joshatron/LED-Cube/4x4x4_build.md

4x4x4 LED Cube Build
====================

Before attempting a full 8x8x8 cube, I started by creating a 4x4x4 one.

Supplies
--------

Materials:

 * 64 LEDs (I chose blue, diffuse is better)
 * 3 ft solid core wire (I had some 22 guage lying around)
 * 15 ft small guage wire (rough approximation, for routing on protoboard)
 * 16 resistors (For mine, I used 200 ohms)
 * 1 large protoboard (Should be at least 4 inches in the smaller dimension)
 * 1 arduino (I used a mega 2560, but an uno should work too)
 * 1 small protoboard (Optional, used to make easy connection to arduino)
 * 20 pin headers (Optional, used to make easy connection to arduino)

Tools:

 * Soldering iron (Ideally a nicer one since you will be doing a lot of soldering)
 * Solder (You will need a pretty good amount of this)
 * Helping hands (Very useful to hold things in place)
 * Soldering fan (Safety first)
 * Solder sucker (Or whatever tool you prefer to unsolder mistakes)
 * Breadboard (Mainly used for testing LEDs)

Procedure
---------

The first step is to create a template.
I tried a 1" separation initially, but had to solder too close to the LEDs and was worried about burning them out.
Instead, I found 7/8" to be a good distance.
Because I plan to also make an 8x8x8, I made the template that size, but feel free to make it just 4x4.
I chose a hole size that fit the LEDs snugly, 1/8" worked best for me.

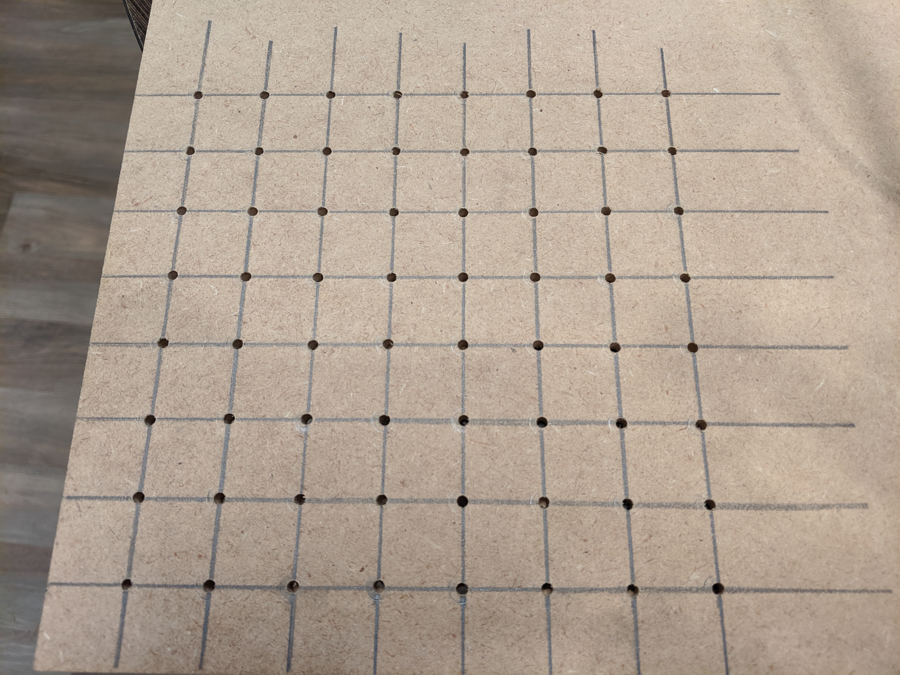
[picture p1: pictures/grid_of_holes.jpg]
Grid of holes


Next is to test and shape all the LEDs.
While not strictly required, it will be very annoying to replace any LEDs, so it is best to test each one.
Once all are known to be good, the cathode and anode must be bent to create the structure of the cube.

The way to bend it is to orient the led to be upside down, the anode on the left, the cathode on the right.
Bend the cathode forward till it is at a right angle.
1/4th of them are done.
They will make the bottom layer.
For the remaining layers, bend the anode left a little, and then use some pliars to bend the last tip right at a right angle.
This way the LEDs can be stacked directly on top of each other.

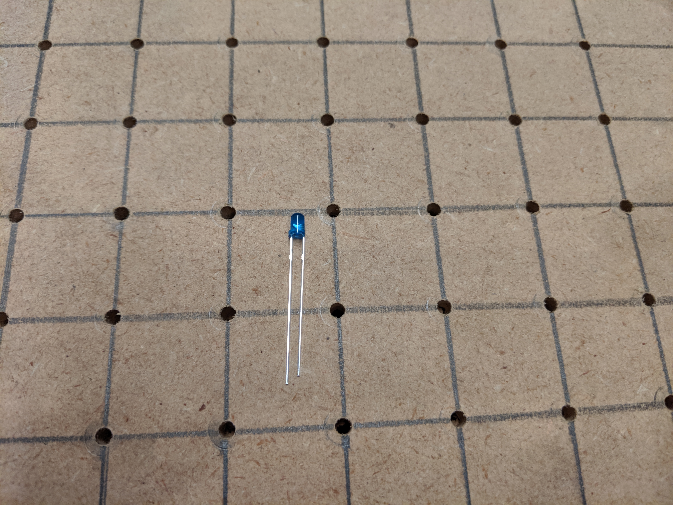
[picture p2: pictures/original_led.jpg]
Starting LED


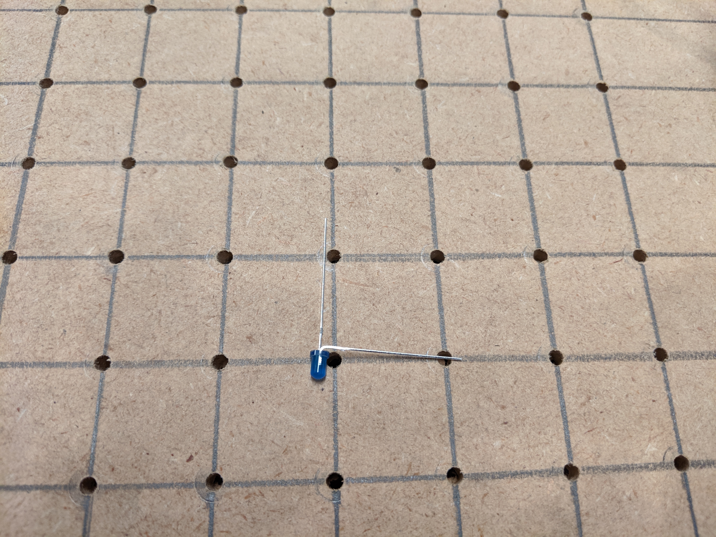
[picture p3: pictures/bent_cathode.jpg]
Bending the cathode


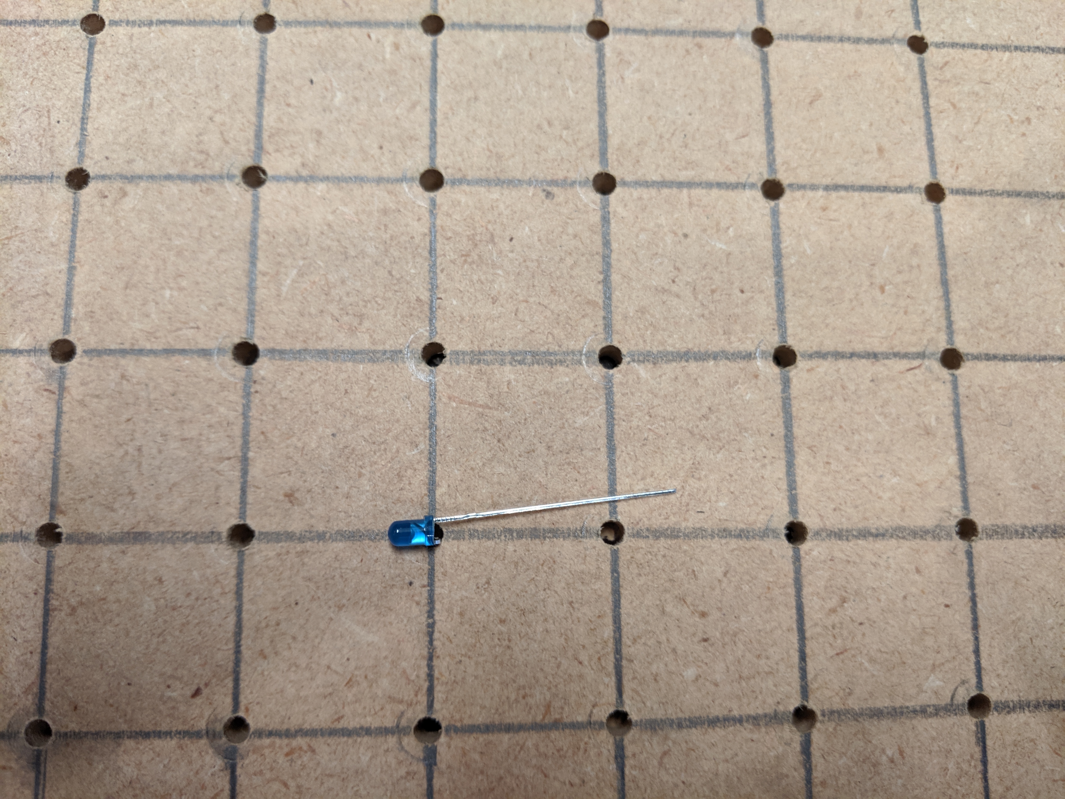
[picture p4: pictures/tilted_anode.jpg]
Tilt out the anode


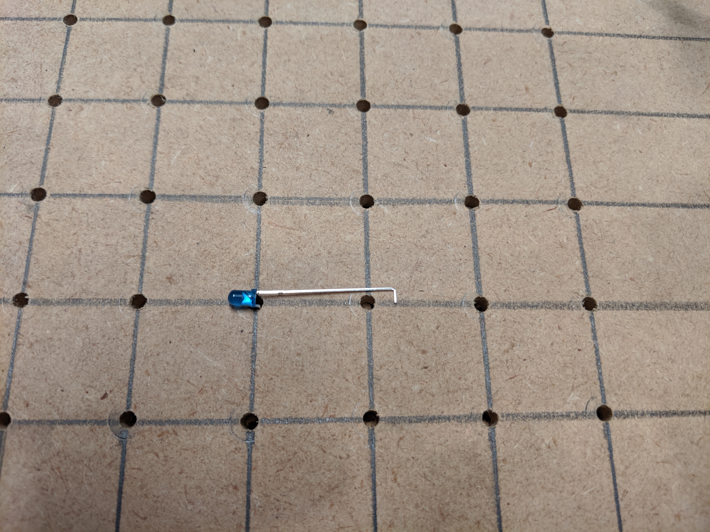
[picture p5: pictures/tilted_and_bent_anode.jpg]
Last bend of anode


The next step is to create the layers.
First, place one row as shown below and solder them together.

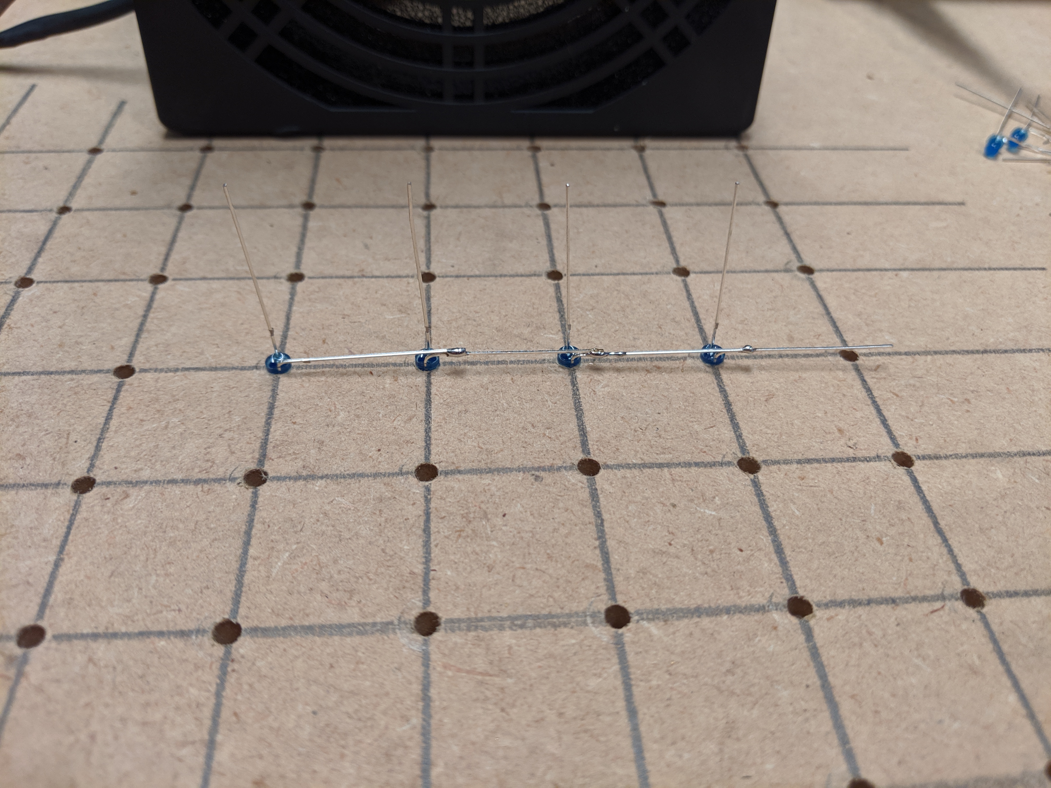
[picture p6: pictures/soldered_first_row.jpg]
First row


Next, add each column, one at a time.

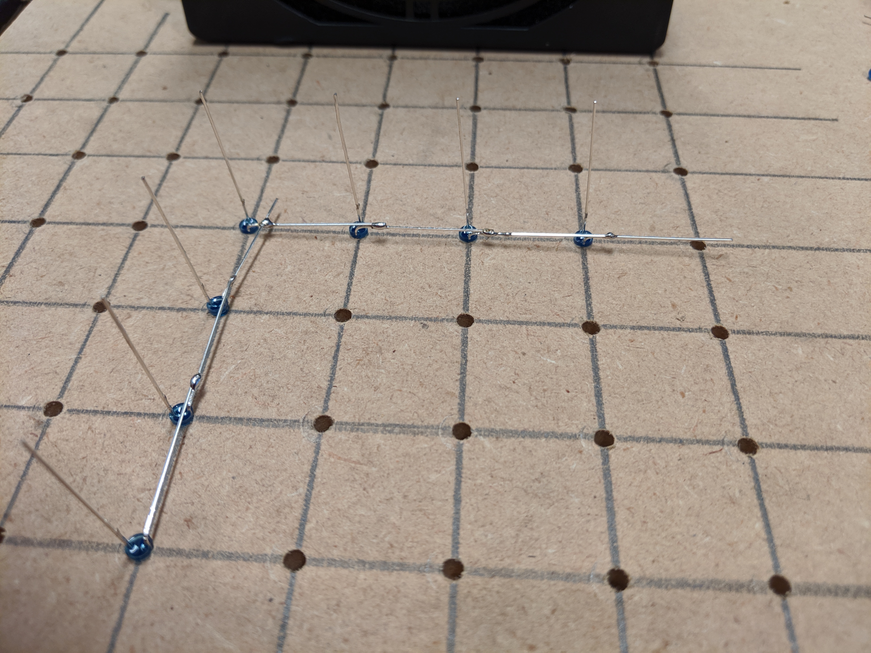
[picture p7: pictures/soldered_first_row_and_column.jpg]
First column


Finally, use some solid core wire to add some structure to the other end of the columns.
I was able to make the wire straight by holding each end with some pliars and pulling.
The wire lengthens slightly, and in the process straightens out better than you could do manually.

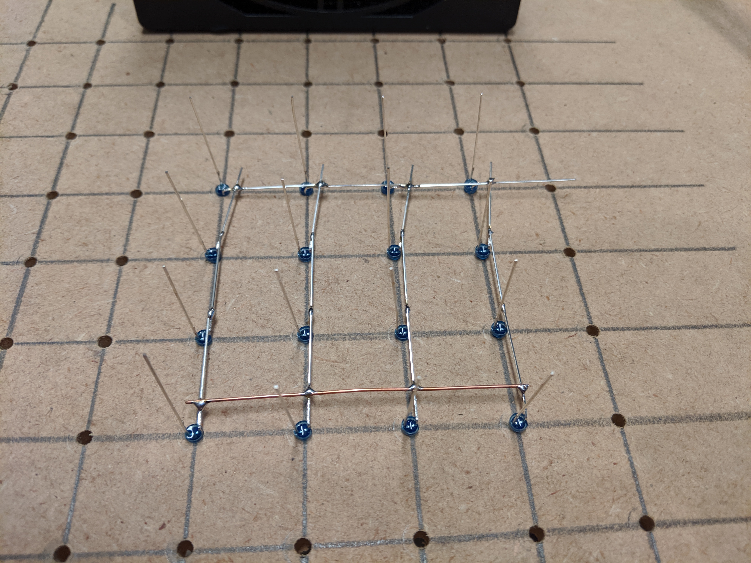
[picture p8: pictures/soldered_full_layer.jpg]
First layer


Repeat this process 3 more times to make all the layers.
Make sure all the LEDs where you only bent the cathode are in the same layer.
After each layer was completed, check all the LEDs again to make sure they are all good.
It is easier to fix it now than in it's final configuration.
To test, attach a ground wire to the cathode sticking out, or any horizontal wire.
Then touch your positive wire against each vertical post.

To finish the cube portion, each layer needs to be soldered to each other.
Start by putting the top layer in the template.
Then roughly position it using helping hands.

Make one corner good height-wise and solder it.
Then do the remaining corners.

Carefully check that the layers are lined up in every way.
This may require some resoldering, along with tilting wires.

Solder the remaining anodes, making sure that the two layers stay lined up.

Finally, test all the LEDs in both rows again like you did for each layer.
This will ensure all the anodes have strong connections through layers and nothing is burned out.

Repeat those steps twice more, making sure the straight anode layer is the bottom layer.

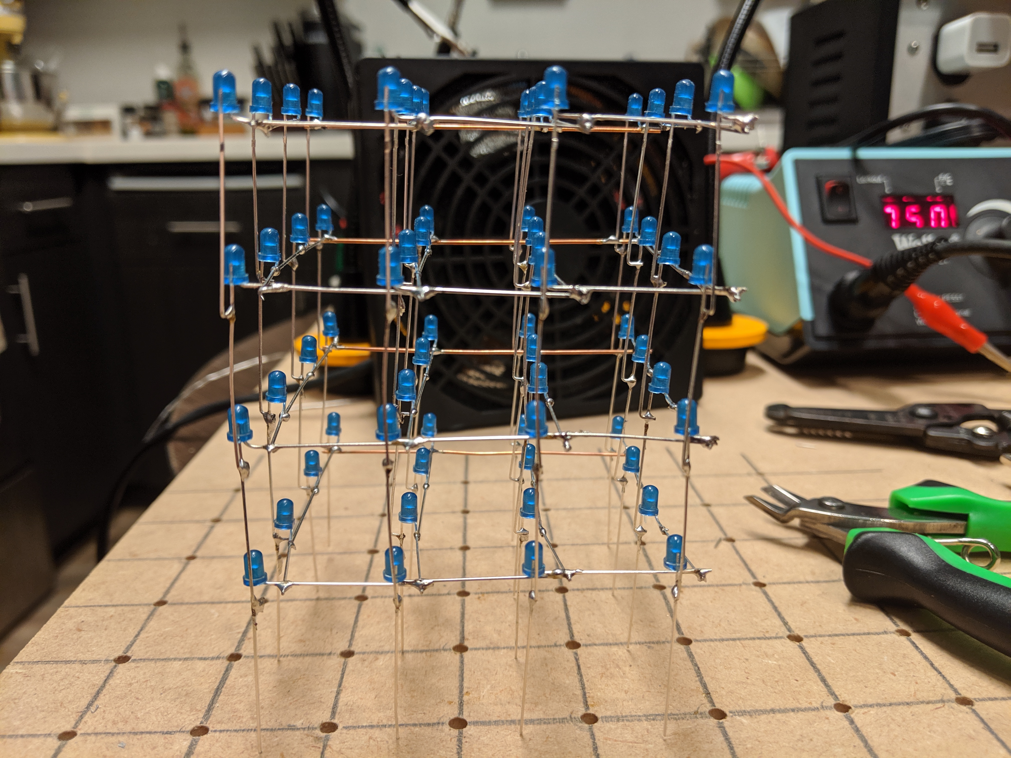
[picture p9: pictures/soldered_layers_together.jpg]
Finished soldering layers


You will need a connection from each cathode layer to the bottom of the cube.
Straighten some more solid core wire and make a small right angle at the end.
Solder one of these L pieces to each layer.
I attached them to the existing solid core wire, but anywhere will do.

The cube is now ready to be tested.
I used male to female jumper wires to connect all the anodes and cathodes to a breadboard.
Then I attached resistors to all the anodes and connected everything to the arduino.

The first test was to make sure everything lit up.
I programmed all the pins for the anodes to write HIGH and all the cathodes to write LOW.

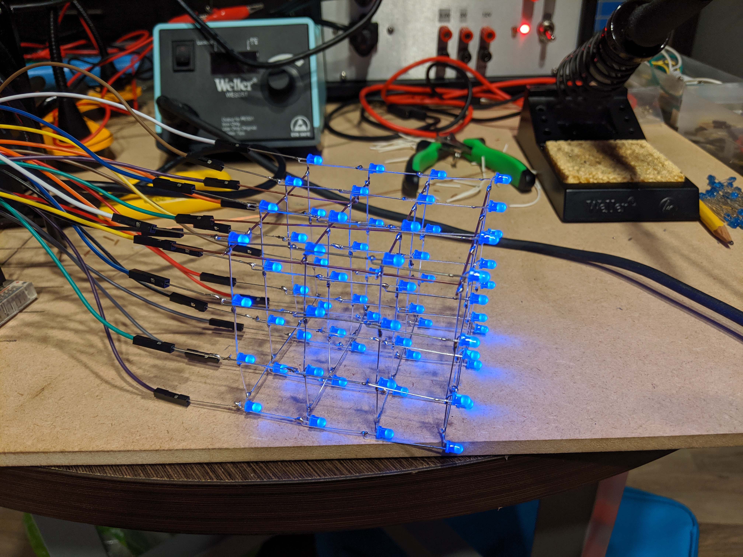
[picture p10: pictures/cube_first_hooked_up_all_lit.jpg]
All LEDs lit up


Then, when I made sure everything was lighting up, I tried making the cube display a pattern with multiplexing.
Multiplexing entails lighting one layer up at a time, and rotating through them fast enough that the eye sees them all lit at once.
The basic loop is:

    Forever
        For each layer
            Set all cathodes to HIGH
            Set anodes up for the layer
            Set layer cathode to LOW
        done
    done

With this technique, you can make it appear that just the outline is lit, which you couldn't otherwise display.

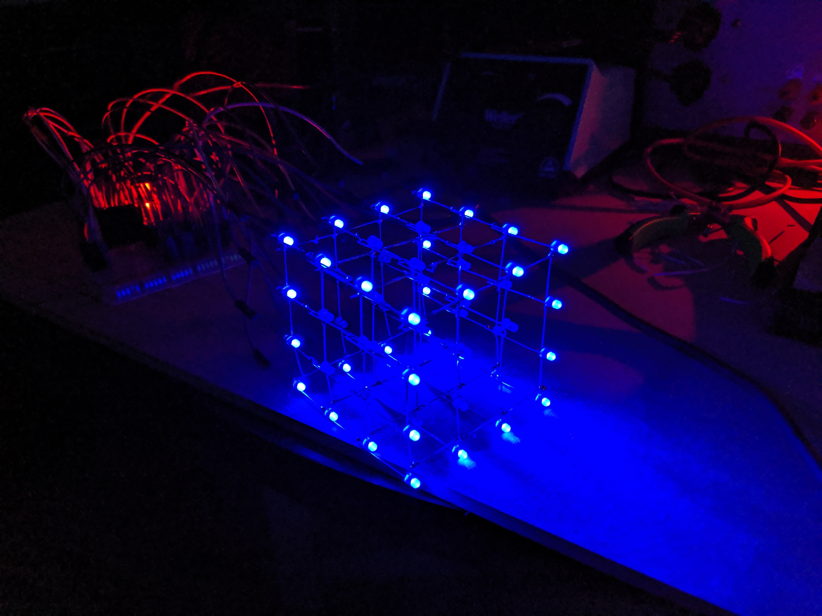
[picture p11: pictures/cube_first_hooked_up_multiplexing.jpg]
Multiplexing outline


Now that the cube is demonstrated to be fully working, it is time to set it up more permanently.
Fitting all the anodes from the LEDs into the holes of the protoboard is a difficult and frustrating task.
The best way I figured to do it was to get the back row through, pull it about an 1/8th inch through, and solder the two corners.
From there, I was able to fit each next row through will less fuss.

When all the holes are through, solder the 4 corners first, then verify everything is level, resoldering as necessary.
Finally, solder the rest of the pins and clip the extra wire from the bottom of the board.

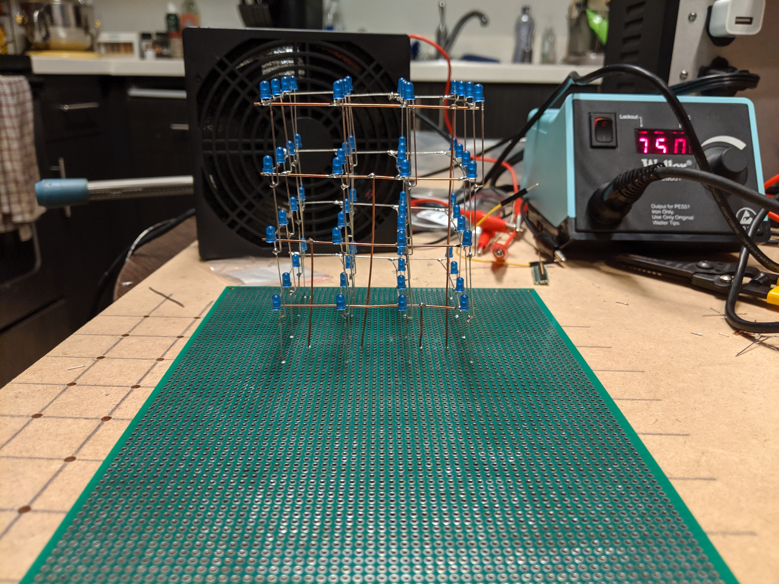
[picture p12: pictures/cube_soldered_to_board.jpg]
Cube on protoboard


The next step is recreating the circuit made originally on the breadboard.
First, solder all 16 resistors to the board in a row.

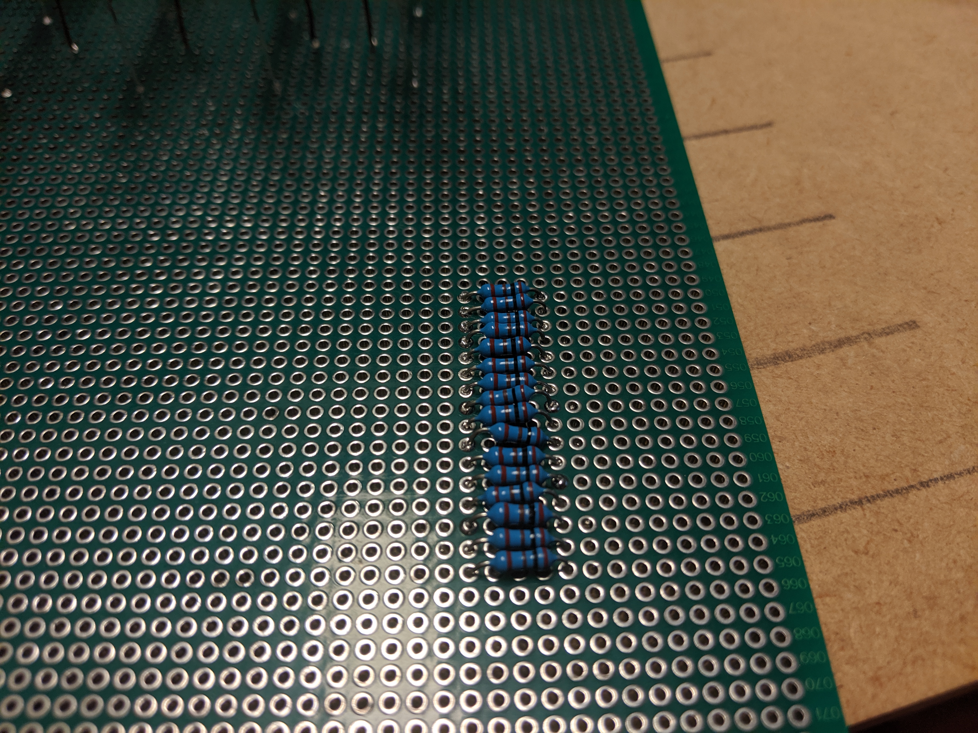
[picture p13: pictures/resistors_soldered_to_board.jpg]
Resistors soldered


Then start hooking up all the anodes to them.
You do not need to follow a specific order, but it will be cleaner if you do.

First row of jumpers

All soldered to resistors

Finally, solder the 4 cathode connections next to the resitors.

Cathodes soldered next to resistors

You now have a nice row of connections ready to hook up to your arduino.
There are several ways you can do this, but I chose to make a 2x10 pin header connection.
This allows me to remove the arduino from the cube with ease.

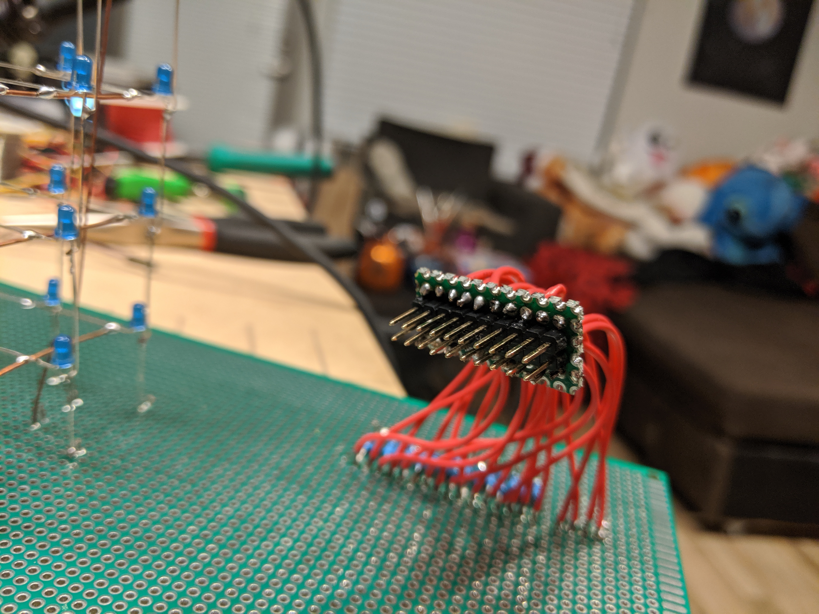
[picture p14: pictures/headers.jpg]
Header for arduino mega


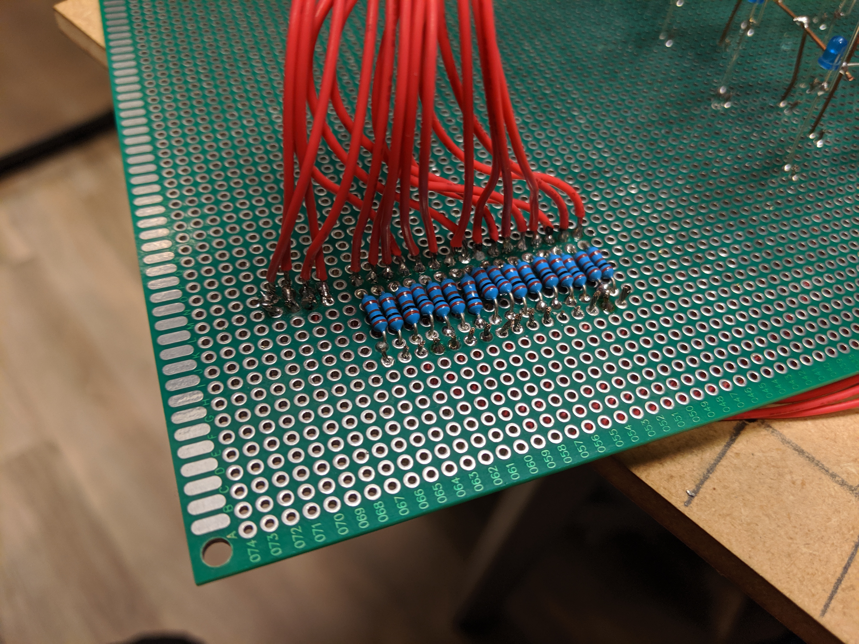
[picture p15: pictures/jumpers_soldered_to_resistors.jpg]
Jumpers connected to resistors


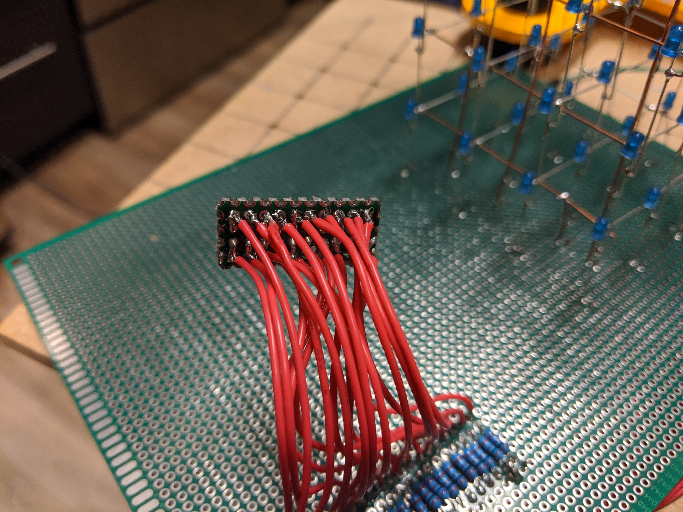
[picture p16: pictures/jumpers_soldered_to_headers.jpg]
Jumpers connected to header


Now it is a simple matter to plug in the arduino.
You should have enough pins to control this with an uno, but you cannot make a compact header like this.
I would recommend making your own arduino shield for connecting.

All that is left is to program the arduino and you are done.

Troubleshooting
---------------

Right when I thought I was done, I noticed some wierd behaviors.
For some of the columns, there seemed to be two LEDs tied to each other.
When only one was on, it wouldn't light, but when both were on they worked fine.

After too much time investigating, I discovered that I had made a solder bridge between two anodes.
When one LED was set HIGH and the other LOW, a short would be made at that point and the LED wouldn't light.
When both were HIGH though they went to the low of the cathode, working fine.

If you notice any problem like this, especially if the cube was working when manually hooked up, look for these shorts.
That will be your most likely culprit.
